PattakanA/YBR-FMS/Robot Picture/Front.jpg

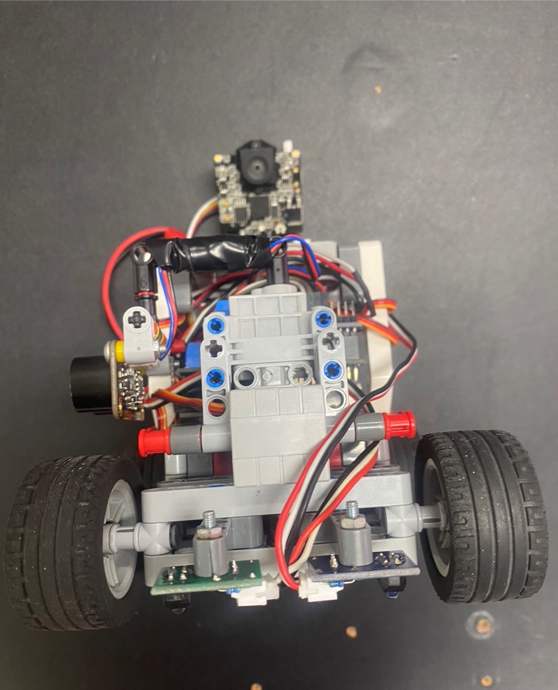
Robot Picture/Front.jpg
