PattakanA/YBR-FMS/Robot Picture/Back.jpg

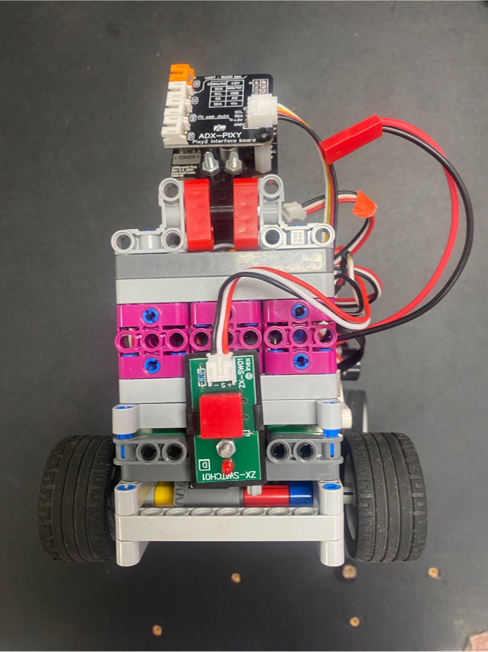
Robot Picture/Back.jpg
