PattakanA/YBR-FMS/Robot Documentation/YBR-FMS.pdf

## WRO Future Engineer 2023

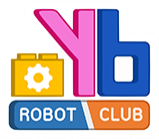
[picture p3: figure]

## By Yothinburana School Robot Club

## สารบัญ

## 1. รูปถ่ายทมีงานและหุ่นยนต์

## 2. ข้อมูลทางวิศวกรรม

## 2.1 การจัดการการเคลื่อนไหว

## 2.2 การจัดการพลังงานและการตรวจเช็ค

## 2.3 การจัดการอุปสรรค

## 2.4 ปัจจัยทางวิศวกรรม

## 3. YouTube Link

## 4. GitHub Link

## รูปภาพหุ่นยนต์

บน | ล่าง

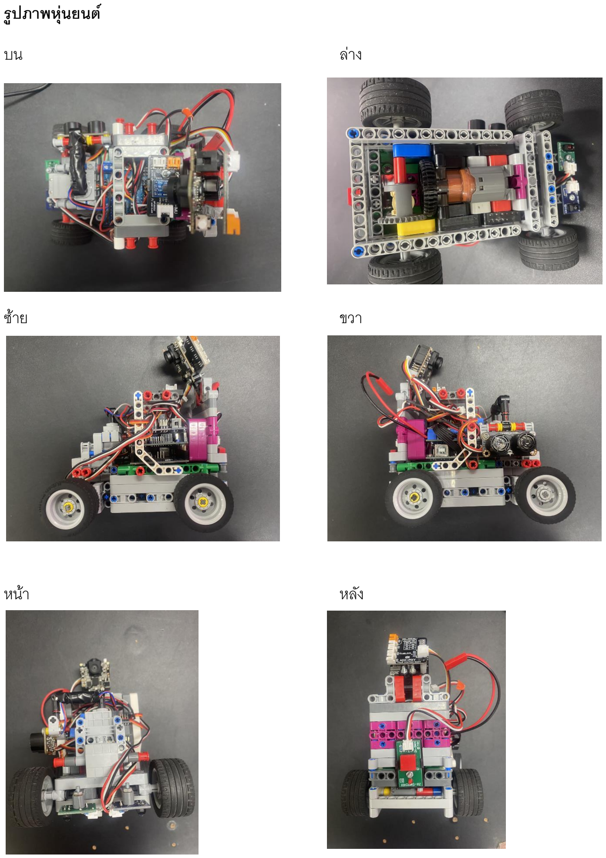
[picture p4: page 3]

ซ้าย | ขวา
หน้า | หลัง

## รูปภาพทมี

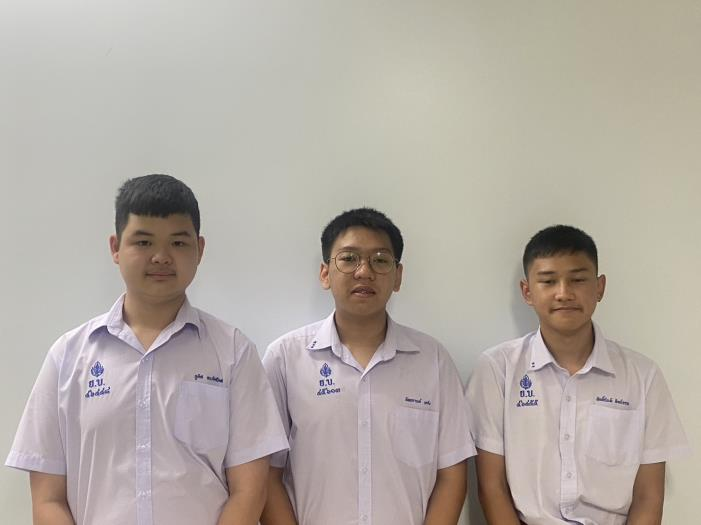
[picture p5: figure]
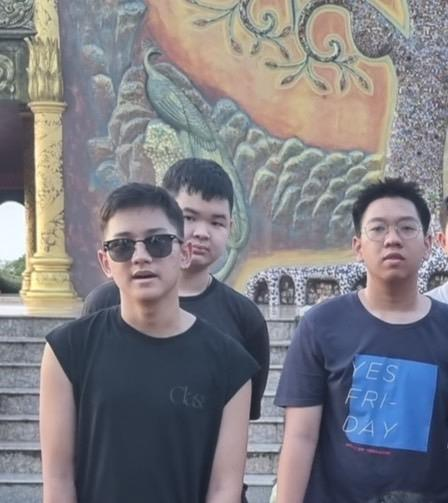
[picture p6: figure]

## ข้อมูลทางวิศวกรรม

## 2.1 การจัดการการเคลื่อนไหว

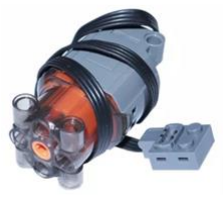
[picture p7: figure]

## Power Function L-Motor

# ในการขับเคลื่อนของหุ่นเป็นมอเตอร์ที่ใช้ง่าย

# และสามารถเอามาดัดแปลงเพื่อเชื่อมต่อกับหุ่นยนต์ได้ง่าย ซึ่งมอเตอร์ยังมีความเร็วที่สูงและมีประสิทธิภาพมาก

## ลักษณะของอุปกรณ์

## นา ้หนัก:

## ความเร็วสูงสุดและ

## ปริมาณกระแสไฟฟ้า:

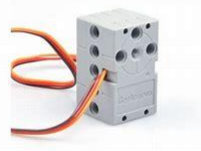
[picture p8: figure]

## Geekservo 2kg 360 Degrees

# ในการเลี้ยวของหุ่นยนต์และใช้หมุน Ultrasonic Sensor

# เป็น Servo ที่ใช้กับ LEGO ใช้ง่ายและสะดวกต่อการสร้างหุ่นยนต์

PF Large

42g

390rpm

120mA

## ลักษณะของอุปกรณ์

# - ความเร็วในการหมุนแกน 60องศา/0.12วินาที - แรงบิด 2 กิโลกรัมเซนติเมตร ที่ไฟเลี้ยง 4.8 V - กระแสไฟฟ้าขณะบังคับแกนหมุน (Stall) 600ถึง 700 mA - กระแสไฟฟ้าสงบขณะหยุดการท างาน 7mA - ความกว้างของสัญญาณพัลส์ที่ต้องการ 0.6 ถึง 2.4 มิลลิวินาที - หมุนได้ 0 ถึง 360 องศา

# Code การหมุน servo เพื่อให้ไปในทิศทางที่ในต้องการ

## 2.2 การจัดการพลังงานและการตรวจเช็ค

## ZX-03 Reflector ในการตรวจค่าสีบนสนาม 2 ตัว

## Light Reflector เป็ น sensor

## ทใี่ ช้วัดค่าแสงเงาสะท้อนในสนาม

## เพอื่ ตรวจสอบเส้นในสนามส าหรับหุ่นยนต์เวลาเลีย้ว

## sensor GY-25 (Sensor GYRO)

## ในการก าหนดทิศทางของหุ่นยนต์เพอื่ ให้

## หุ่นยนต์เดินเป็ นเส้นตรงและสามารถเลีย้ว

## ไปในทศิทางทกี่ า หนด

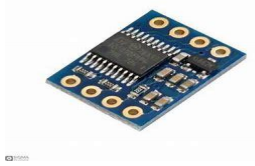
[picture p9: figure]

## Dataset : http://mkpochtoi.ru/GY25_Manual_EN.pdf

## Library: http://github.com/ElectronicCats/mpu6050

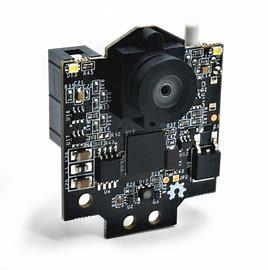
[picture p10: figure]

## Pixy2.1

## ใช้ในการตรวจจับสิ่งกีดขวางและสีของสิ่ง

## กีดขวางบนสนามเพอื่ ให้สามารถหลบไปใน

## ทศิทางที่ถูกต้องได้

## Module เป็นกล้องทมี่ าพร้อมกับ

## Library และ Function

## Documentation :

## https://docs.pixycam/wiki/doku.php?id=wiki:v2:start

## Software and Library : https://pixycam.com/downloads-pixy2/

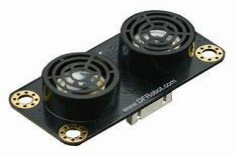
[picture p11: figure]

## Ultrasonic Sensor (SEN0307)

## เพอื่ วัดระยะห่างของหุ่นยนตก์ับผนังท าให้สามารถ

## ควบคุมหุ่นยนตใ์ห้อยู่ในจุดของสนามทเี่ราต้องการได้

## Sensor ตัวนีม้ ีการวัดระยะทางทแี่ ม่นยา อยู่ ที่ +-1%

โดยมีความละเอียดเท่ากับ 1 ซม.

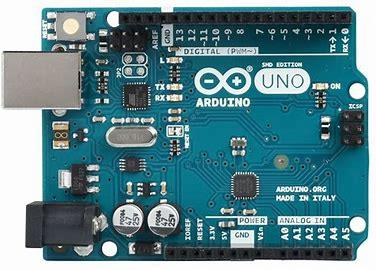
[picture p12: figure]

## Arduino UNO

## เป็ นเสมือนแกนกลางส าคัญส าหรับหุ่นยนต์

## ทสี่ ามารถเอาไว้เชื่อมต่ออุปกรณต์ ่างๆเอาไว้ด้วยกัน

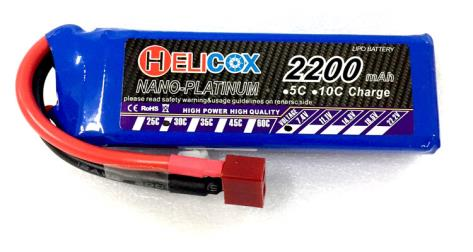
[picture p13: figure]

## แบตเตอรี่ลิโพ Helicox 2200mah(7.4V)

## เป็ นเสมือนตัวให้พลังงานหุ่นยนต์เพอื่ ให้สามารถ ท างานได้

# การเดินสาย

### // Motor

### ENB -> Arduino UNO Pin 11

### INB -> Arduino UNO Pin 13

### // Servos

### STEER_SRV -> Arduino UNO Pin 9

### ULTRA_SRV -> Arduino UNO Pin 8

### // Ultrasonic Sensor

### ULTRA_PIN -> Arduino UNO Pin 2

### // Light Sensors

### RED _SEN -> Arduino UNO Pin 5

### BLUE _SEN -> Arduino UNO Pin 1

### // Button

### BUTTON -> Arduino UNO Pin 3

### // Pixy Camera

### PIXY_SDA -> Arduino UNO Pin 4

### PIXY_SCL -> Arduino UNO Pin 5

### // Gryo

### TX -> Arduino UNO RX

### RX -> Arduino UNO TX

### // Battery

### BATTERY -> PWR_IN of Arduino UNO

# 2.3 การจัดการอุปสรรค

## 2.3.1 รอบคัดเลือก

หุ่นยนตจ์ะใช้Ultrasonic sensor เพื่อคำ นวณหำระยะทำงระหวำ่ งกำ แพงกบั หุ่นเพื่อที่จะนำ ระยะทำงของหุ่นจำก กำ แพงและ องศำของ sensor gyro มำหลงัจำกน้นั นำ มำคำ นวณเป็น steering degree (องศำกำรเล้ียว)

## เพื่อใหห้ ุ่นคงระยะห่ำงระหวำ่ งกำ แพงไดด้ว้ยสูตร Proportional Integral Derivative (PID)

# สูตรกำรเดิน

getIMU();

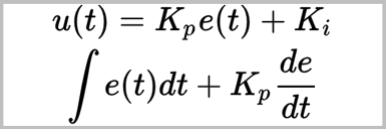
[picture p14: figure]

line_detection();
ultra_servo(pvYaw, TURN);
int wall_distance = getDistance();
motor_and_steer(-1 * compassPID.Run(pvYaw + ((wall_distance – 35 * 1) * ((float(TURN == 'R') - 0.5) * 2)));

## 2.3.2 รอบชิง

## หุ่นยนตจ์ะใช้Pixy camera เพื่อมองหอุปสรรค Ultrasonic sensor และ Gyro เพื่อน ำมำค ำนวณ

### steering degree (องศำกำรเล้ียว)

หุ่นยนตย์งัคงใช้PID เหมือนกบัรอบคดัเลือก แตจ่ ะมีตวัแปลที่เพิ่มข้ึนมำคือ avoidance degree (องศำในกำร

## เล้ียวหลบ) โดย code จะเป็นดงัต่อไปน้ี สูตรคำ นวนองศำในกำรเล้ียวหลบ

float calculate_avoidance() {
int blocks = pixy.ccc.getBlocks();

found_block = false;

if (blocks) {
int signature = -1; | // Signature of the object you want to detect
int targetHeight = 10; | // Height of the object in centimeters
float focalLength = 2.3; // Focal length of the camera in centimeters float cameraFOV = 80.0; // Field of view of the camera in degrees

int largestBlockIndex = -1;
int largestBlockArea = 0;

for (int i = 0; i < blocks; i++) {
if (pixy.ccc.blocks[i].m_height > 1.33 * float(pixy.ccc.blocks[i].m_width)) {
int objectArea = pixy.ccc.blocks[i].m_width;
// * pixy.ccc.blocks[i].m_height;
found_block = true;
if (objectArea > largestBlockArea) { largestBlockIndex = i;
largestBlockArea = objectArea;
signature = pixy.ccc.blocks[i].m_signature; }
}
}

if (signature != -1) {
int objectHeight = pixy.ccc.blocks[largestBlockIndex].m_height; float distance = (targetHeight * focalLength * 100) / objectHeight;

float blockCenterX = pixy.ccc.blocks[largestBlockIndex].m_x; float blockCenterY = pixy.ccc.blocks[largestBlockIndex].m_y;

float deltaX = blockCenterX - pixy.frameWidth / 2;
float deltaY = blockCenterY - pixy.frameHeight / 2;

float detected_degree = deltaX * 40 / pixy.frameWidth;

float blockPositionX = distance * sin(degreesToRadians(detected_degree)); float blockPositionY = distance * cos(degreesToRadians(detected_degree)) -17;

if (signature == 1) {
avoidance_degree = max(radiansToDegree(atan2(blockPositionX + 9, blockPositionY)), 5);
Blocks_TURN = 'R';
} else {
avoidance_degree = min(radiansToDegree(atan2(blockPositionX - 9, blockPositionY)), -5);
Blocks_TURN = 'L';
}
}
}

return avoidance_degree;
}

2.4 ปัจจัยทางวิศวกรรม หุ่นที่เรำสร้ำงข้ึนมำเป็นหุ่นที่ออกแบบมำเพื่อใชส้ ำ หรับงำนน้ีโดยเฉพำะ โดยใชช้ิ้นส่วน LEGO

## และน็อตต่ำงๆ ในกำรยดึชิ้นส่วนของหุ่นเขำ้ดว้ยกนั

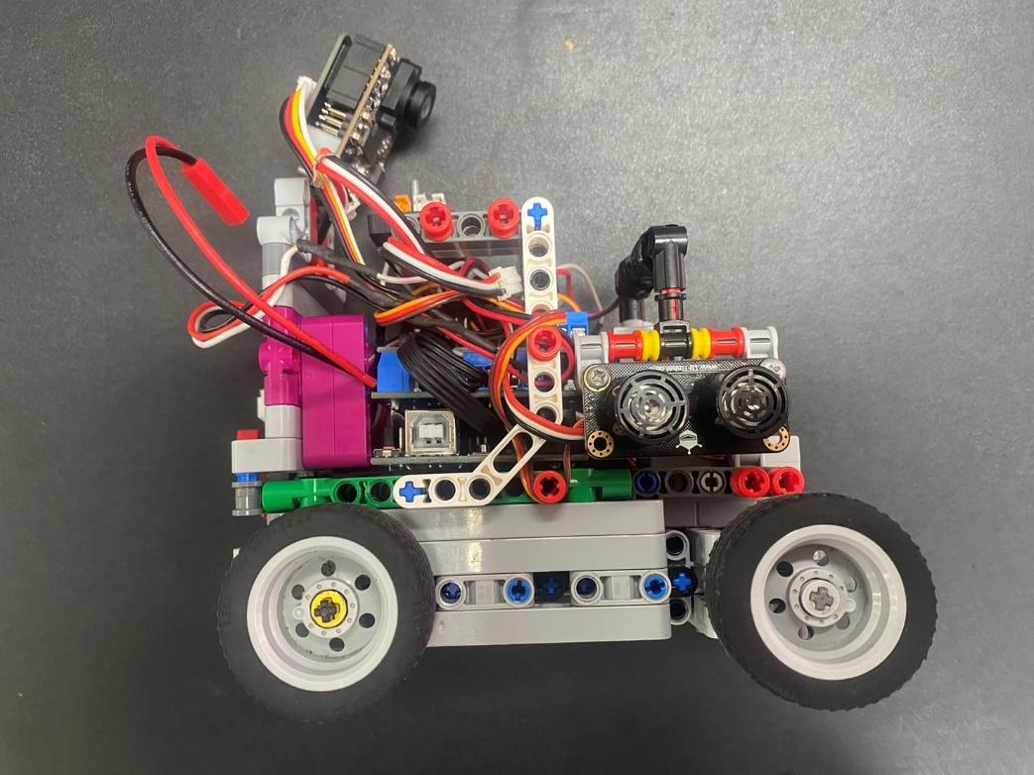
[picture p15: figure]

# ปัญหำของหุ่นที่เรำพบ

## 1. แรงบิดของมอเตอร์

มอเตอร์ตวัน้ีมีแรงบิดอยทู่ ี่ประมำณ 18 N.cm ซ่ึงทำ ใหเ้รำพบวำ่ หำกเรำรันมอเตอร์โดยใช้แบตเตอรี่ลิโพ

## 7.4V ที่ power ประมาณ 20-30% จะสำมำรถทำ ใหห้ ุ่นยนตเ์ริ่มเคลื่อนที่ได้

## 2. แบตเตอรี่ลิโพ

เนื่องจำก Arduino UNO ไม่มีindicator ที่ใชเ้ตือนวำ่แบตเตอรี่หมด เรำจึงต้องวัด แบตเตอรี่อยตู่ ลอด

## แบตเตอรี่ ไม่ควรมปีระจุตา ่ กว่า 7.7V เพรำะค่ำของ Program อำจจะผิดพลำดได้

### 3. Gyro Drift

ปรำกฏกำรณ์ที่เอำตพ์ ตุ ของไจโรสโคปค่อยๆ เบี่ยงเบนไปจำกค่ำที่คำดไวเ้มื่อเวลำผำ่ นไป เพรำะฉะน้นั ตอนเปิดหุ่น ของเรำ จา เป็นต้องวางหุ่นไว้ทพี่ ืน้ สนามก่อน รอให้หุ่นนิ่งอยู่กบัทกี่ ่อนและจงึจะค่อยๆ เสียบแบตเตอรี่ได้

### 4. Loose Power Connection

บำงคร้ังหุ่นจะ reset ตัวเอง เกิดจำกสำยที่เสียบเขำ้ที่ Arduino UNO อำจจะหลวม หรือบดักรีสำยไม่ดีท ำ

## ใหม้ ่สำมำรถแจกจ่ำยไฟฟ้ำอยำ่ งเพียงพอสำ หรับ Pixy camera, Ultrasonic sensor, Light

### sensor 2 ตัว, Gyro sensor, servo และ motor ไดอ้ยำ่ งทวั่ ถึง

## 3. YouTube Video

## Qualification Round (ทำ ภำรกิจสำ เร็จประมำณ 31 วินำที)

### https://youtu.be/7kWcytFyiAU

## 4. GitHub link

### https://github.com/PattakanA/YBR-FMS

### YB Robot Club [YBR-FMS]
