PattakanA/YBR-FMS/Robot Picture/Bottom.jpg

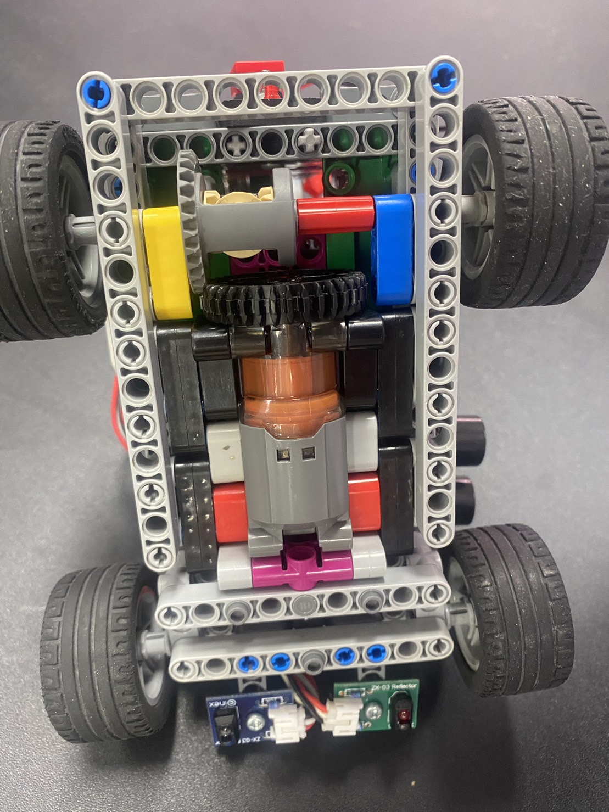
Robot Picture/Bottom.jpg
