PattakanA/YBR-FMS/Robot Picture/Left.jpg

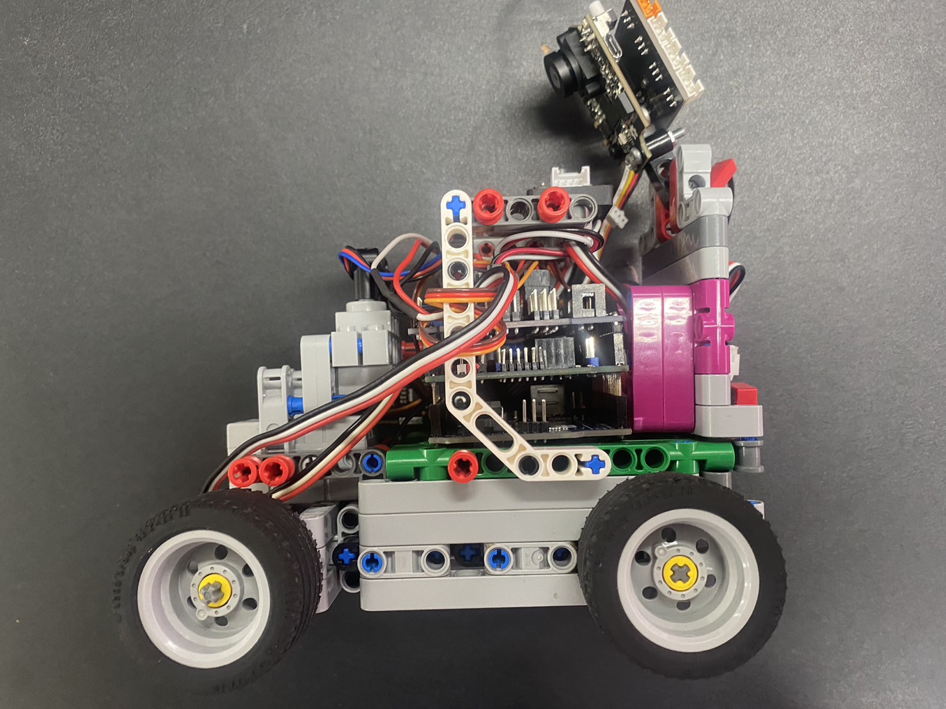
Robot Picture/Left.jpg
