PattakanA/YBR-FMS/Robot Picture/Top.jpg

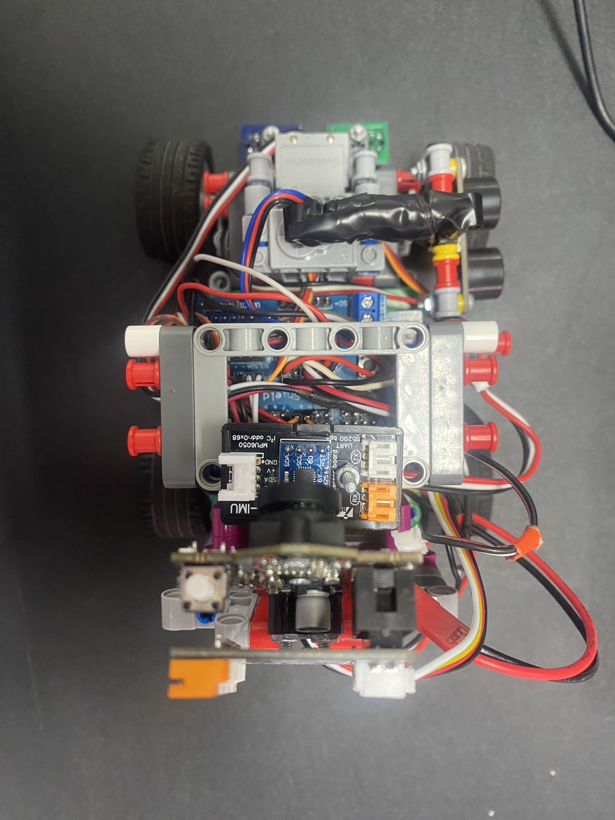
Robot Picture/Top.jpg
