PattakanA/YBR-FMS/Team Picture/Formal.jpg

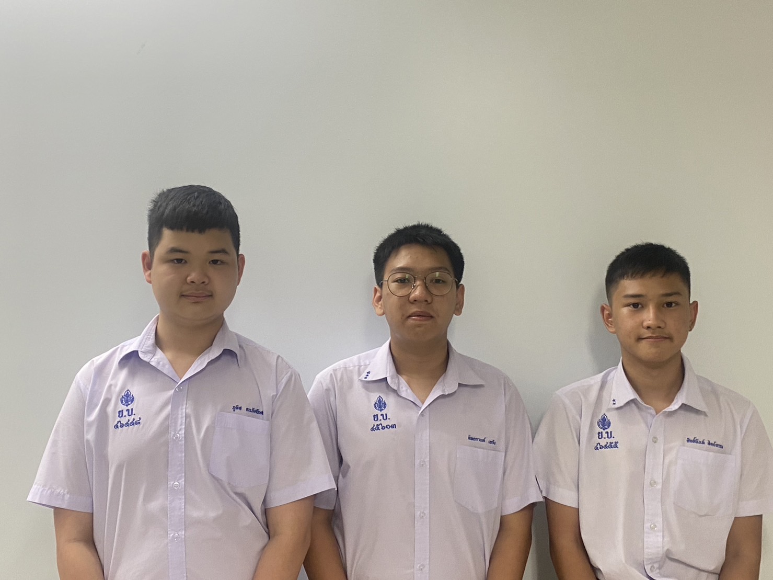
Team Picture/Formal.jpg
